lonelyloli/Portable-Multi-Parameter-Patient-Monitor-Based-ON-ESP-NOW/Schematic/PastMontFIX.sch

## EAGLE design Schematic/PastMontFIX.sch (2026-08-03)

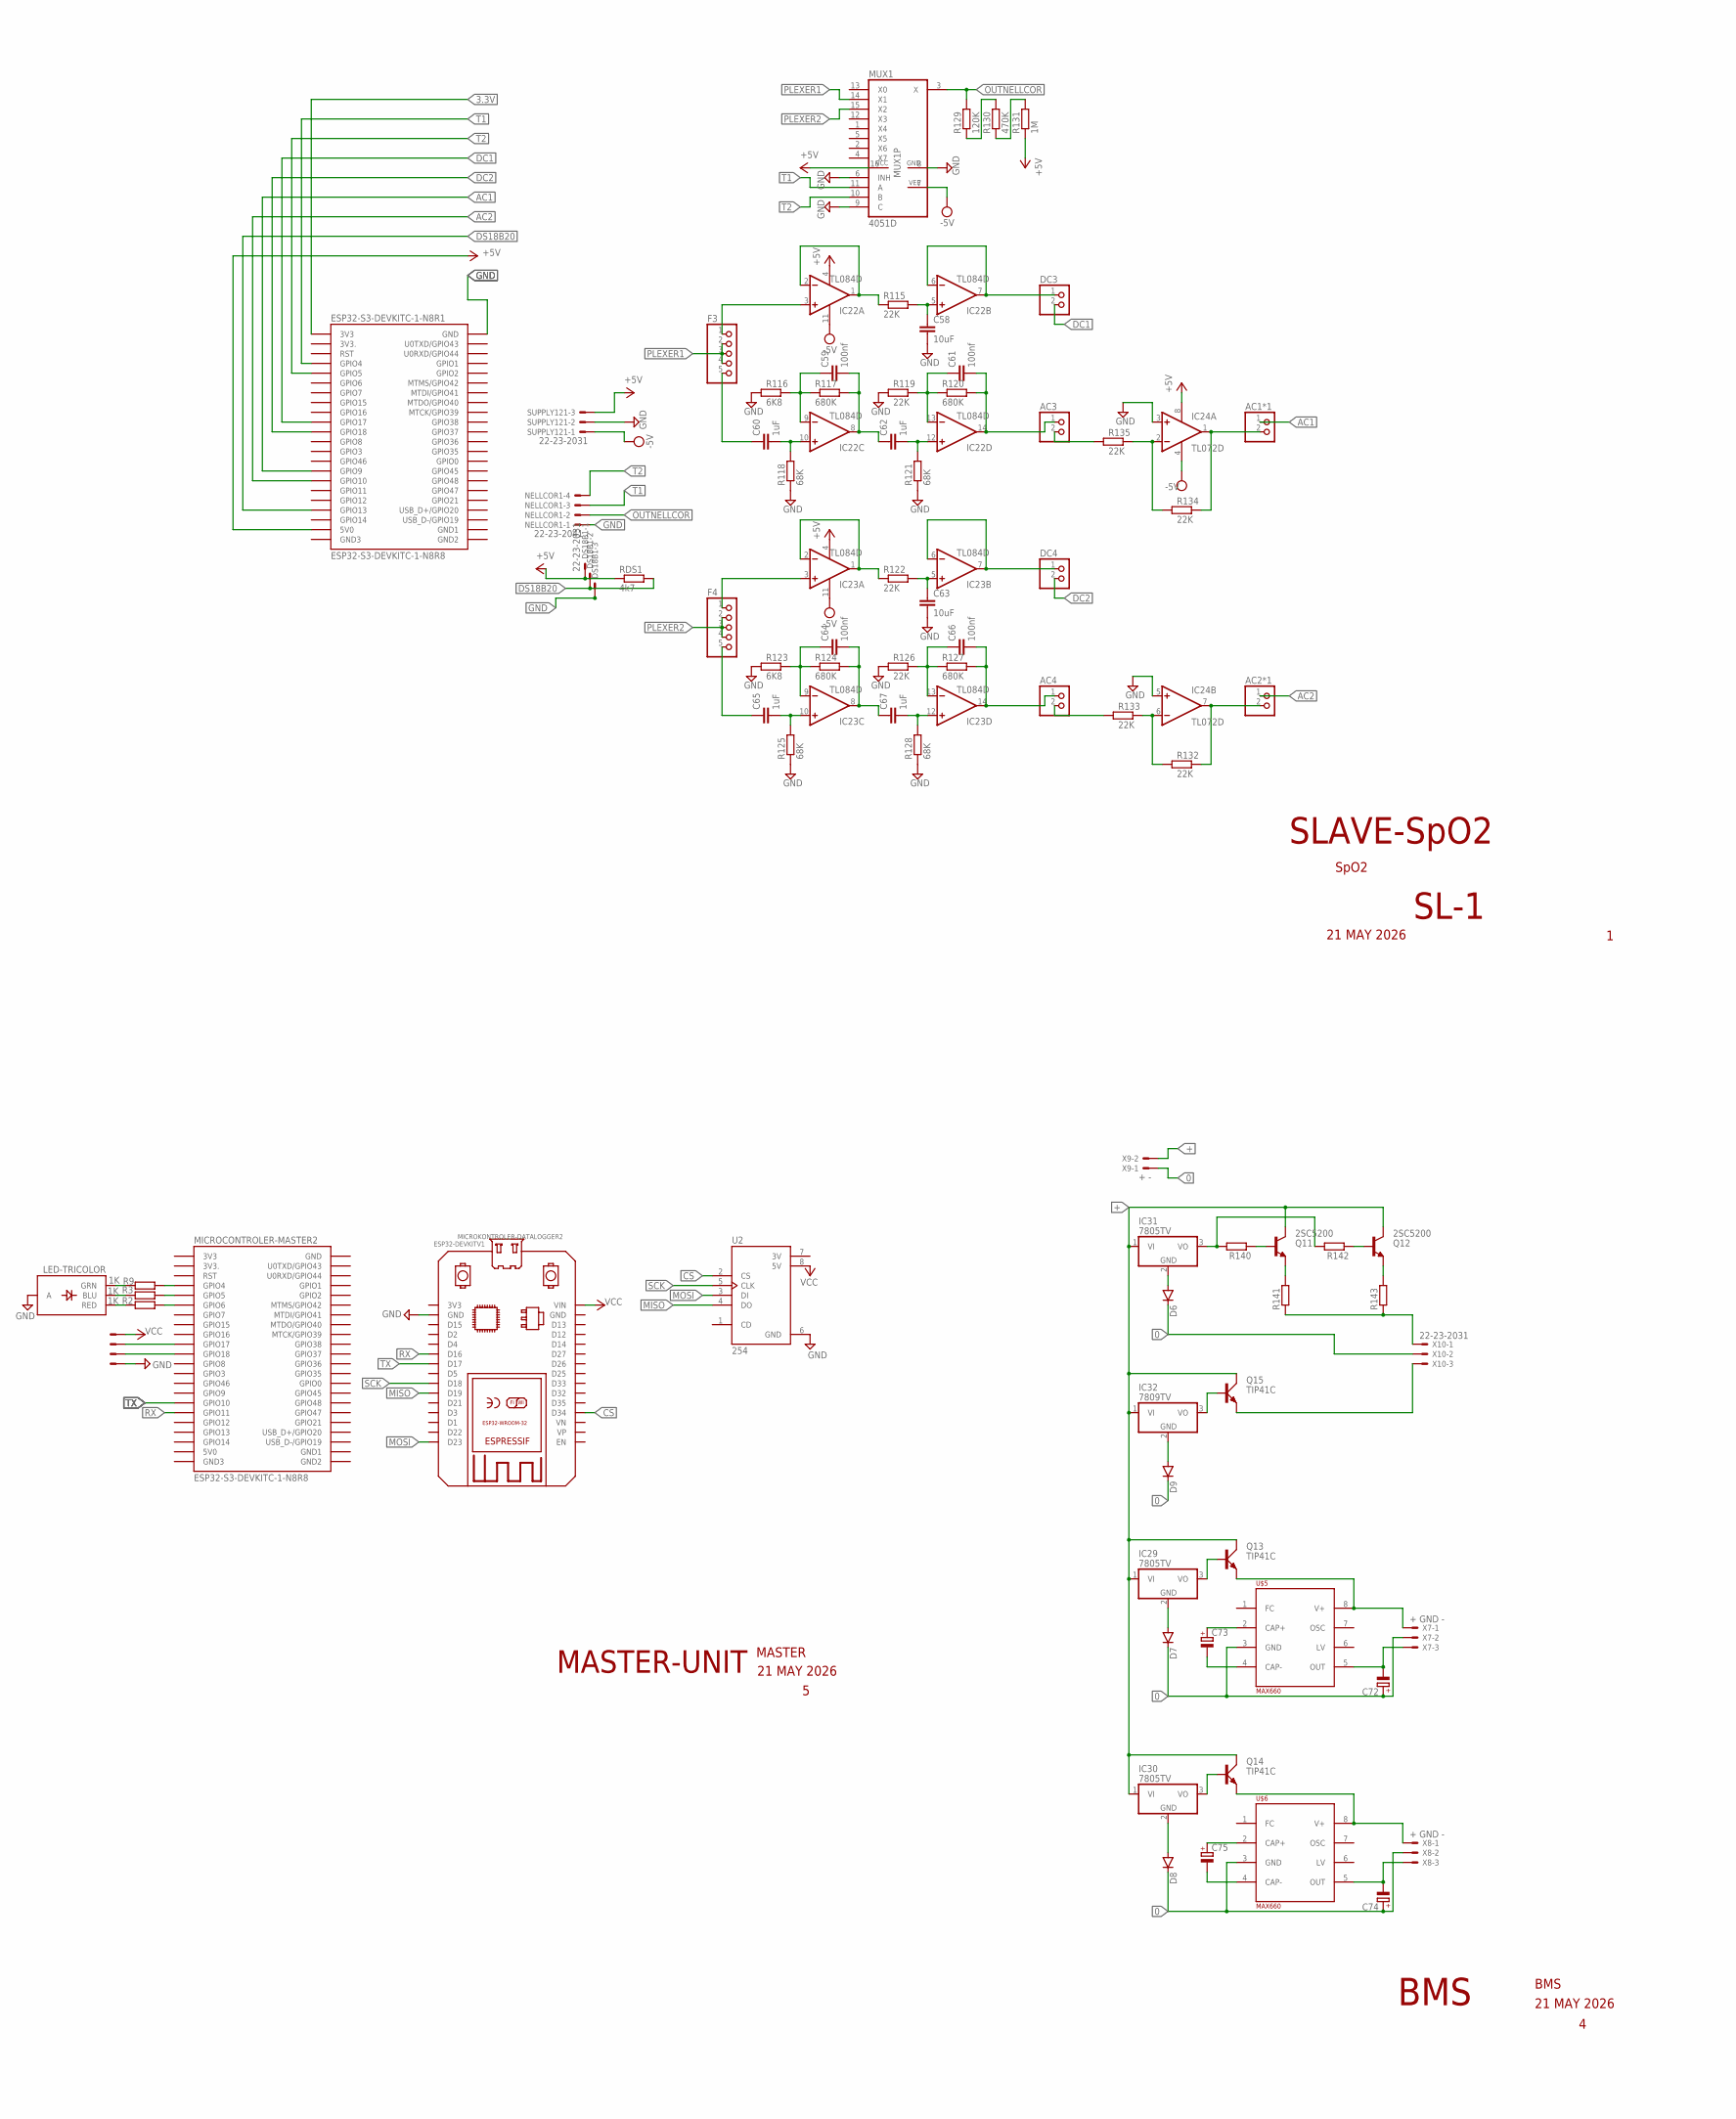
[picture p6: schematic PastMontFIX.sch, part in row 1, column 1]

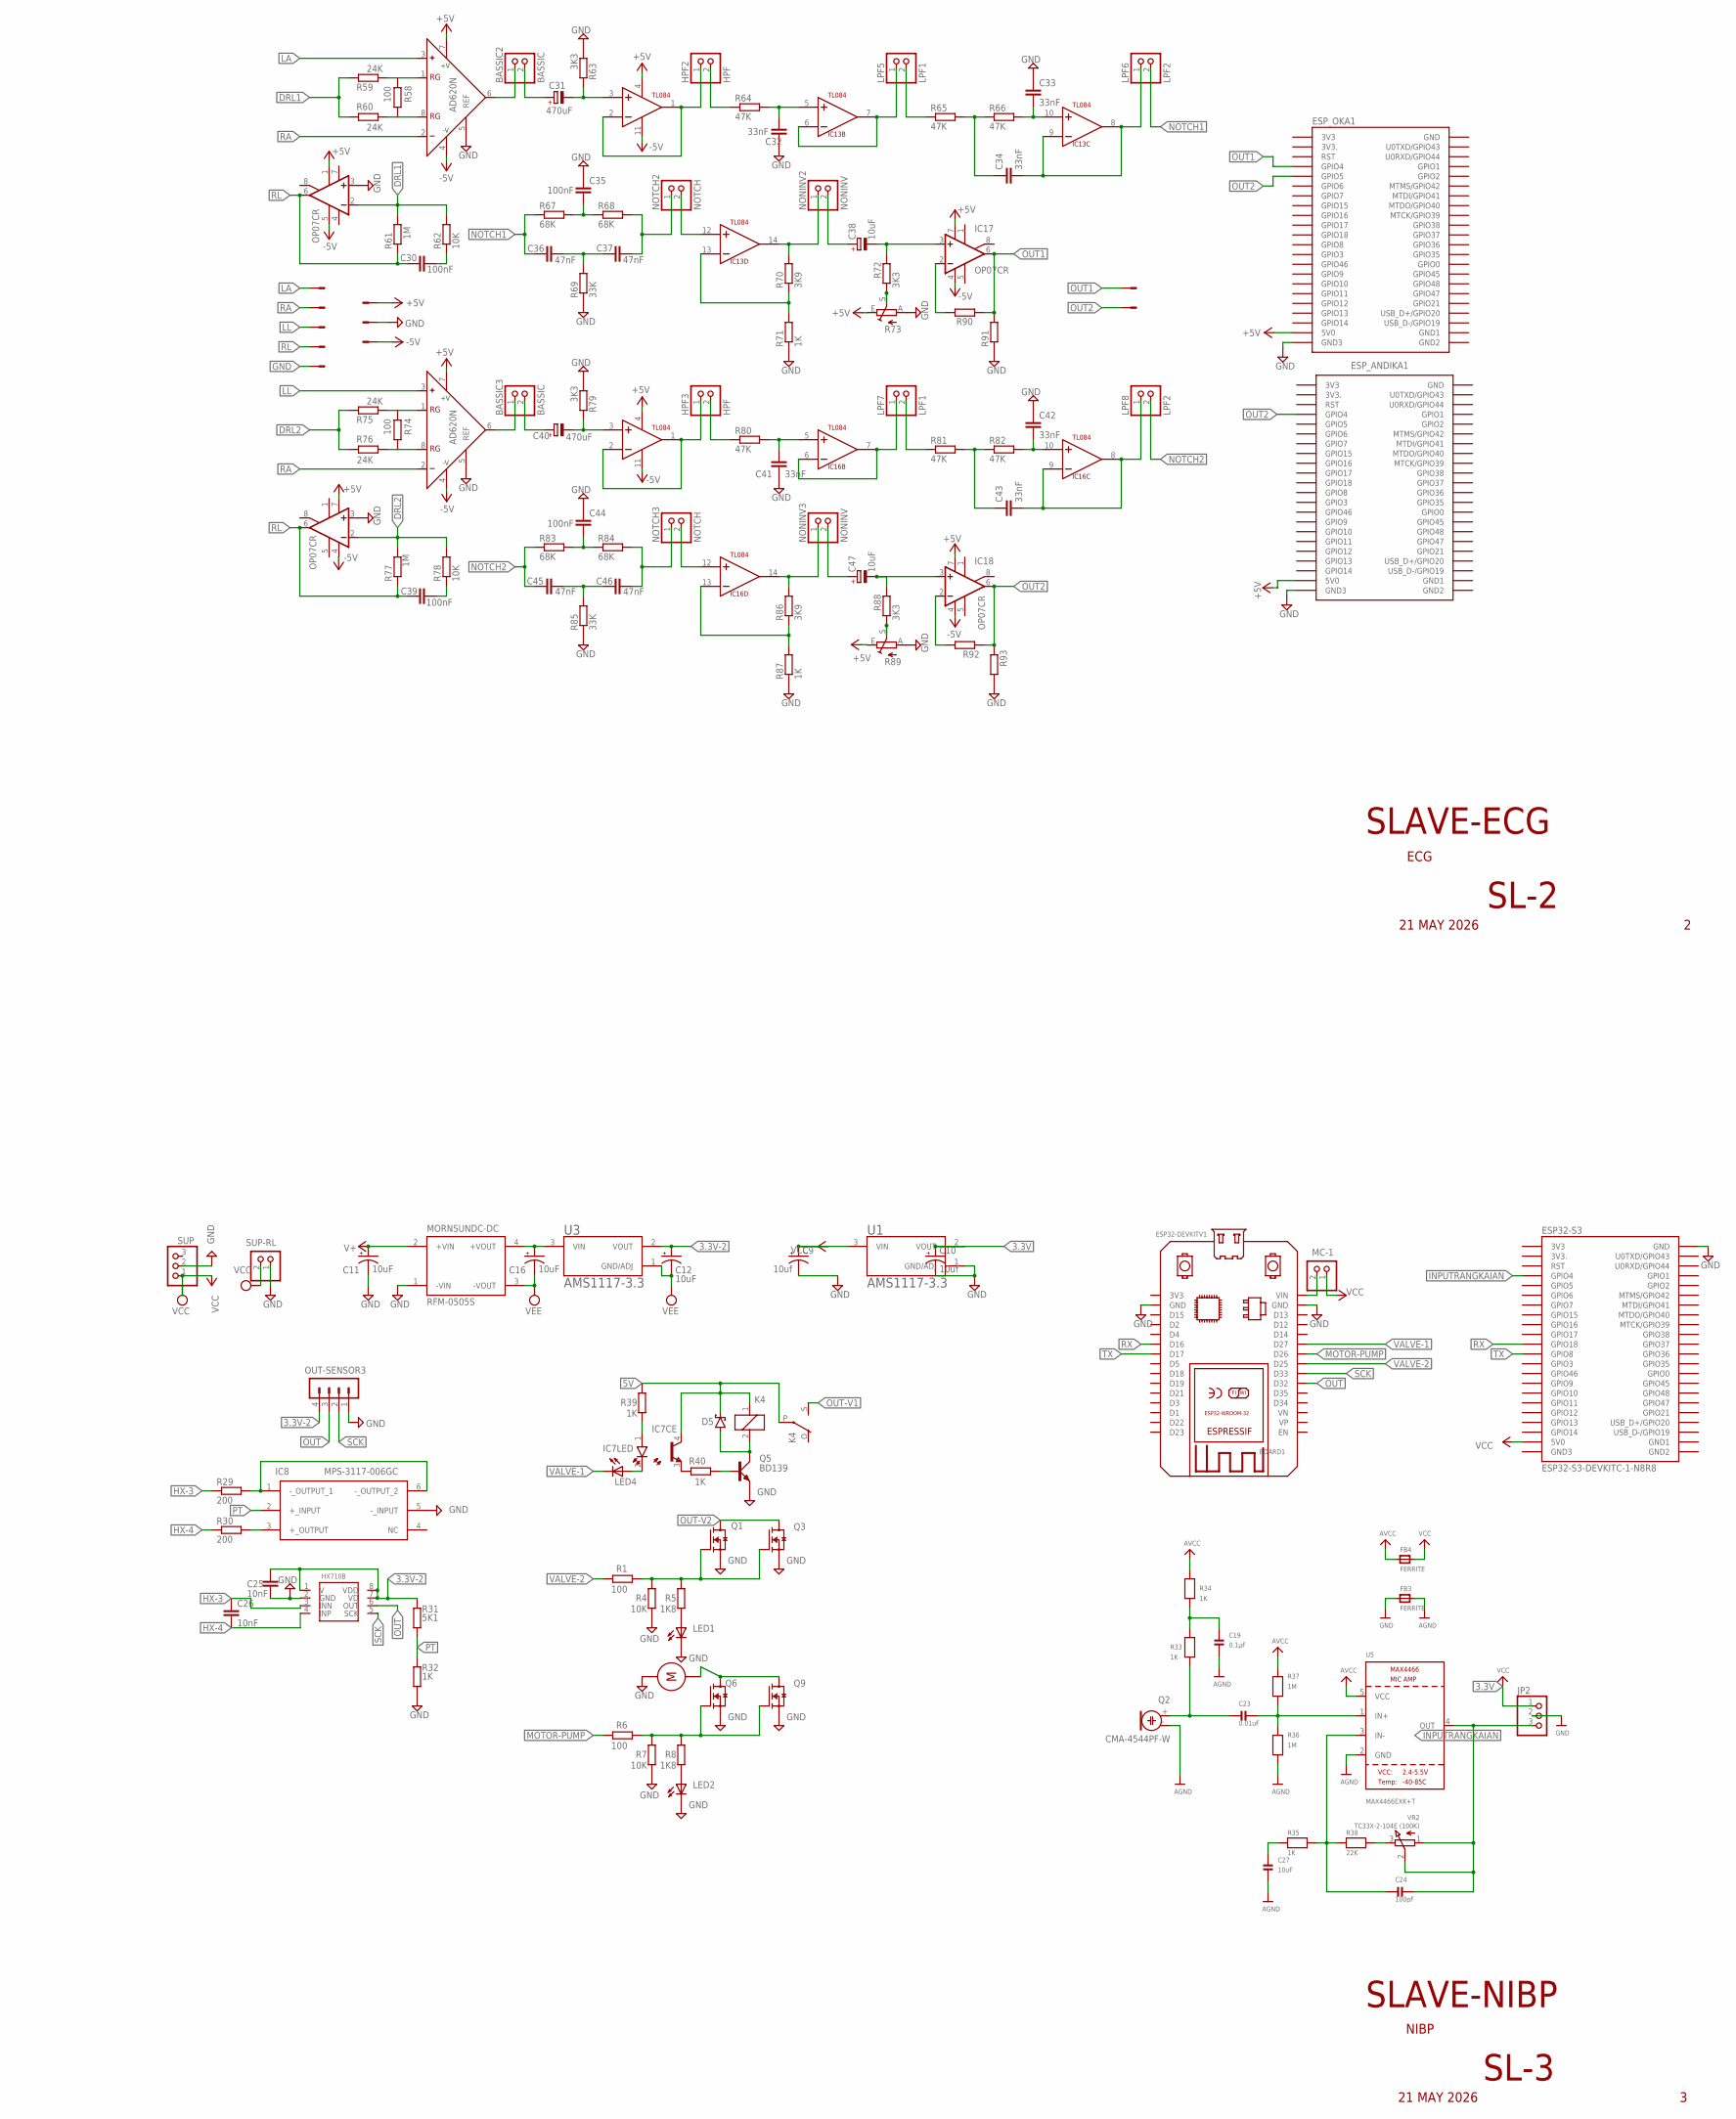
[picture p7: schematic PastMontFIX.sch, part in row 1, column 2]

Parts:
AC1*1, AC2*1, AC3, AC4: PINHD-1X2; 1X02
BASSIC2, BASSIC3: BASSIC; 1X02
BOARD1: ESP32DEVKITV1; ESP32-DEVKITV1
C9, C10: 10uf; 150CLZ-0810
C11, C12, C16: 10uF; 150CLZ-1014
C19: 0.1µF; 0805
C23: 0.01uF; 0805
C24: 100pF; 0805
C25, C26: 10nF; C1206
C27: 10uF; 0805
C30, C35, C39, C44: 100nF; C1206
C31, C40: 470uF; 150CLZ-1010
C32, C33, C34, C41, C42, C43: 33nF; C1206
C36, C37, C45, C46: 47nF; C1206
C38, C47: 10uF; 150CLZ-0810
C58, C63: 10uF; C1206
C59, C61, C64, C66: 100nf; C1206
C60, C62, C65, C67: 1uF; C1206
C72, C73, C74, C75: CPOL-EU150CLZ-0810; 150CLZ-0810
D5: MBRS130LT3; SMB
D6, D7, D8, D9: DIODE-DO41-7.6; DO41-7.6
DC3, DC4: PINHD-1X2; 1X02
DS18B1: 22-23-2031
ESP32-S3, ESP32-S3-DEVKITC-1-N8R1: ESP32-S3-DEVKITC-1-N8R8
ESP_ANDIKA1: ESP32-S3-DEVKITC-1-N8R8
ESP_OKA1: EWE; ESP32-S3-DEVKITC-1-N8R8
F3, F4: PINHD-1X5; 1X05
FB3, FB4: FERRITE; 0805
HPF2, HPF3: HPF; 1X02
HX710B: HX710B; SOP-8
IC7: SFH6156; SFH
IC8: MPS-3117-006GC; MPS3117006GC
IC11, IC14: AD620N; DIL08
IC12, IC15, IC17, IC18: OP07CR; SO08
IC13, IC16: TL084; SO14
IC22, IC23: TL084D; SO14
IC24: TL072D; SO08
IC29, IC30, IC31: 7805TV; TO220V
IC32: 7809TV; TO220V
JP2: HEADER-1X376MIL; 1X03_ROUND_76
K4: ZF112
LED1, LED2, LED4: LEDCHIPLED_1206; CHIPLED_1206
LPF5, LPF7: LPF1; 1X02
LPF6, LPF8: LPF2; 1X02
M1: 308-100
MC-1: PINHD-1X2; 1X02
MICROCONTROLER-MASTER2: ESP32-S3-DEVKITC-1-N8R8
MICROKONTROLER-DATALOGGER2: ESP32DEVKITV1; ESP32-DEVKITV1
MORNSUNDC-DC: RFM-0505S; CONV_RFM-0505S
MUX1: 4051D; SO16
NELLCOR1: 22-23-2041
NEX: 22-23-2041
NONINV2, NONINV3: NONINV; 1X02
NOTCH2, NOTCH3: NOTCH; 1X02
OUT1: 22-23-2021
OUT-SENSOR3: MA04-1
POWER1: 22-23-2031
Q1, Q3, Q6, Q9: AOD4184A; DPAK228P994X240-4N
Q2: CMA-4544PF-W; ELECTRET_9.7
Q5: BD139; TO126AV
Q11, Q12: 2SC5200; TO545P2020X520X2910-3
Q13, Q14, Q15: TIP41C; TO220AV
R1, R6: 100; M1206
R2, R3, R9, R32, R39, R40: 1K; M1206
R4, R7: 10K; M1206
R5, R8: 1K8; M1206
R29, R30: 200; M1206
R31: 5K1; M1206
R33, R34, R35: 1K; 0805
R36, R37: 1M; 0805
R38: 22K; 0805
R58, R74: 100; R1206
R59, R60, R75, R76: 24K; R1206
R61, R77, R131: 1M; R1206
R62, R78: 10K; R1206
R63, R72, R79, R88: 3K3; R1206
R64, R65, R66, R80, R81, R82: 47K; R1206
R67, R68, R83, R84, R118, R121, R125, R128: 68K; R1206
R69, R85: 33K; R1206
R70, R86: 3K9; R1206
R71, R87: 1K; R1206
R73, R89: TRIM_EU-CA6V; CA6V
R90, R91, R92, R93: R-EU_R1206; R1206
R115, R119, R122, R126, R132, R133, R134, R135: 22K; R1206
R116, R123: 6K8; R1206
R117, R120, R124, R127: 680K; R1206
R129: 120K; R1206
R130: 470K; R1206
R140, R142: R-EU_0617/17; 0617/17
R141, R143: R-EU_0922/22; 0922/22
RDS1: 4k7; R1206
SUP: PINHD-1X3; 1X03
SUP-RL: PINHD-1X2; 1X02
SUPPLY121: 22-23-2031
U1, U3: AMS1117-3.3; SOT229P700X180-4N
U2: 254; MODULE_254
U5: MAX4466EXK+T; SC70-5
U$2: LED-TRICOLOR; LED-TRICOLOR-SMD
U$5, U$6: MAX660; SO08
VR2: TC33X-2-104E (100K); TRIMPOT_BOURNS_TC33X-2
X2: 22-23-2051
X7, X8: + GND -; 22-23-2031
X9: + -; 22-23-2021
X10: 22-23-2031

Connections:
0: C72.+, C74.+, D6.C, D7.C, D8.C, D9.C, U$5.3 (GND), U$6.3 (GND), X7.2, X8.2, X9.1, X10.2
3.3V: C10.+, ESP32-S3-DEVKITC-1-N8R1.J1_1 (3V3), JP2.1, U1.2 (VOUT)
3.3V-2: C12.+, C25.1, HX710B.1 (V), HX710B.7 (VD), HX710B.8 (VDD), OUT-SENSOR3.4, R31.1, U3.2 (VOUT)
5V: D5.C, IC7.4 (C), K4.1, K4.P, R39.2
+: IC29.1 (VI), IC30.1 (VI), IC31.1 (VI), IC32.1 (VI), Q11.2 (C), Q12.2 (C), Q13.C, Q14.C, Q15.C, X9.2
+5V: ESP_ANDIKA1.J1_21 (5V0), ESP_OKA1.J1_21 (5V0), IC11.4 (-V), IC11.7 (+V), IC12.1 (ON1), IC12.5 (OPT), IC13.4 (VCC+), IC13.11 (VCC-), IC14.4 (-V), IC14.7 (+V), IC15.4 (V-), IC15.7 (V+), IC16.4 (VCC+), IC16.11 (VCC-), IC17.4 (V-), IC17.7 (V+), IC18.4 (V-), IC18.7 (V+), POWER1.1, POWER1.3, R73.E, R89.E
AC1: AC1*1.1, ESP32-S3-DEVKITC-1-N8R1.J1_15 (GPIO9)
AC2: AC2*1.1, ESP32-S3-DEVKITC-1-N8R1.J1_16 (GPIO10)
AGND: C19.2, C27.2, FB3.2, Q2.- (1), R36.1, U5.2 (GND)
AVCC: FB4.1, R34.2, R37.2, U5.5 (VCC)
CS: MICROKONTROLER-DATALOGGER2.D34, U2.2 (CS)
DC1: DC3.2, ESP32-S3-DEVKITC-1-N8R1.J1_10 (GPIO17)
DC2: DC4.2, ESP32-S3-DEVKITC-1-N8R1.J1_11 (GPIO18)
DRL1: IC12.2 (-IN), R59.2, R60.2, R61.2, R62.2
DRL2: IC15.2 (-IN), R75.2, R76.2, R77.2, R78.2
DS18B20: DS18B1.2, ESP32-S3-DEVKITC-1-N8R1.J1_19 (GPIO13), RDS1.2
GND: BOARD1.GND, BOARD1.GND@1 (GND), C9.-, C10.-, C11.-, C25.2, C32.2, C33.1, C35.1, C41.2, C42.1, C44.1, C58.2, C63.2, DS18B1.3, ESP32-S3.J3_1 (GND), ESP32-S3-DEVKITC-1-N8R1.J3_1 (GND), ESP_ANDIKA1.J1_22 (GND3), ESP_OKA1.J1_22 (GND3), FB3.1, HX710B.2 (GND), IC8.5 (-_INPUT), IC11.5 (REF), IC12.3 (+IN), IC14.5 (REF), IC15.3 (+IN), IC24.3 (+IN), IC24.5 (+IN), JP2.2, LED1.C, LED2.C, M1.NEG, MICROKONTROLER-DATALOGGER2.GND@1 (GND), MORNSUNDC-DC.1 (-VIN), MUX1.6 (INH), MUX1.8 (GND), MUX1.9 (C), NELLCOR1.1, NEX.4, OUT-SENSOR3.1, POWER1.2, Q1.3 (S), Q3.3 (S), Q5.E, Q6.3 (S), Q9.3 (S), R4.1, R7.1, R32.2, R63.1, R69.1, R71.1, R73.A, R79.1, R85.1, R87.1, R89.A, R91.1, R93.2, R116.1, R118.1, R119.1, R121.1, R123.1, R125.1, R126.1, R128.1, SUP.2, SUP-RL.1, SUPPLY121.2, U1.1 (GND/ADJ), U2.6 (GND), U$2.A, X2.5
HX-3: C26.1, HX710B.3 (INN), R29.1
HX-4: C26.2, HX710B.4 (INP), R30.1
INPUTRANGKAIAN: C24.1, ESP32-S3.J1_4 (GPIO4), JP2.3, U5.4 (OUT), VR2.1 (A), VR2.2 (S)
LA: IC11.3 (+), X2.1
LL: IC14.3 (+), X2.3
MISO: MICROKONTROLER-DATALOGGER2.D19, U2.4 (DO)
MOSI: MICROKONTROLER-DATALOGGER2.D23, U2.3 (DI)
MOTOR-PUMP: BOARD1.D26, R6.1
unnamed: LED1.A, R5.1
unnamed: C16.+, MORNSUNDC-DC.4 (+VOUT), U3.3 (VIN)
unnamed: Q1.1 (G), Q3.1 (G), R1.2, R4.2, R5.2
unnamed: LED2.A, R8.1
unnamed: Q6.1 (G), Q9.1 (G), R6.2, R7.2, R8.2
unnamed: R9.1, U$2.G (GRN)
unnamed: R3.1, U$2.B (BLU)
unnamed: R2.1, U$2.R (RED)
unnamed: MICROCONTROLER-MASTER2.J1_6 (GPIO6), R2.2
unnamed: MICROCONTROLER-MASTER2.J1_5 (GPIO5), R3.2
unnamed: BOARD1.VIN, MC-1.2
unnamed: MICROCONTROLER-MASTER2.J1_4 (GPIO4), R9.2
unnamed: MICROCONTROLER-MASTER2.J1_10 (GPIO17), NEX.2
unnamed: MICROCONTROLER-MASTER2.J1_11 (GPIO18), NEX.3
unnamed: IC8.1 (-_OUTPUT_1), IC8.6 (-_OUTPUT_2), R29.2
unnamed: IC8.3 (+_OUTPUT), R30.2
unnamed: C23.1, Q2.+ (2), R33.1
unnamed: C19.1, R33.2, R34.1
unnamed: C23.2, R36.2, R37.1, U5.1 (IN+)
unnamed: C24.2, R35.2, R38.1, U5.3 (IN-)
unnamed: C27.1, R35.1
unnamed: R38.2, VR2.3 (E)
unnamed: Q5.B, R40.1
unnamed: D5.A, K4.2, Q5.C
unnamed: IC7.2 (K), LED4.A
unnamed: IC7.1 (A), R39.1
unnamed: IC7.3 (E), R40.2
unnamed: IC11.8 (RG), R58.1, R60.1
unnamed: IC11.1 (RG), R58.2, R59.1
unnamed: BASSIC2.1, IC11.6 (OUT)
unnamed: BASSIC2.2, C31.+
unnamed: C31.-, IC13.3 (IN+), R63.2
unnamed: HPF2.1, IC13.1 (OUT), IC13.2 (IN-)
unnamed: C32.1, IC13.5 (IN+), R64.2
unnamed: IC13.6 (IN-), IC13.7 (OUT), LPF5.1
unnamed: C34.1, R65.2, R66.1
unnamed: C33.2, IC13.10 (IN+), R66.2
unnamed: C34.2, IC13.8 (OUT), IC13.9 (IN-), LPF6.1
unnamed: C35.2, R67.2, R68.1
unnamed: C36.2, C37.1, R69.2
unnamed: C37.2, NOTCH2.1, R68.2
unnamed: HPF2.2, R64.1
unnamed: LPF5.2, R65.1
unnamed: IC13.14 (OUT), NONINV2.1, R70.2
unnamed: IC13.13 (IN-), R70.1, R71.2
unnamed: C38.+, NONINV2.2
unnamed: R72.1, R73.S
unnamed: IC13.12 (IN+), NOTCH2.2
unnamed: C30.2, R62.1
unnamed: IC14.8 (RG), R74.1, R76.1
unnamed: IC14.1 (RG), R74.2, R75.1
unnamed: BASSIC3.1, IC14.6 (OUT)
unnamed: BASSIC3.2, C40.+
unnamed: C40.-, IC16.3 (IN+), R79.2
unnamed: HPF3.1, IC16.1 (OUT), IC16.2 (IN-)
unnamed: C41.1, IC16.5 (IN+), R80.2
unnamed: IC16.6 (IN-), IC16.7 (OUT), LPF7.1
unnamed: C43.1, R81.2, R82.1
unnamed: C42.2, IC16.10 (IN+), R82.2
unnamed: C43.2, IC16.8 (OUT), IC16.9 (IN-), LPF8.1
unnamed: C44.2, R83.2, R84.1
unnamed: C45.2, C46.1, R85.2
unnamed: C46.2, NOTCH3.1, R84.2
unnamed: HPF3.2, R80.1
unnamed: LPF7.2, R81.1
unnamed: IC16.14 (OUT), NONINV3.1, R86.2
unnamed: IC16.13 (IN-), R86.1, R87.2
unnamed: C47.+, NONINV3.2
unnamed: R88.1, R89.S
unnamed: IC16.12 (IN+), NOTCH3.2
unnamed: C39.2, R78.1
unnamed: IC17.2 (-IN), R90.1
unnamed: IC18.2 (-IN), R92.2
unnamed: C47.-, IC18.3 (+IN), R88.2
unnamed: C38.-, IC17.3 (+IN), R72.2
unnamed: IC22.1 (OUT), IC22.2 (-IN), R115.1
unnamed: DC3.1, IC22.6 (-IN), IC22.7 (OUT)
unnamed: C58.1, IC22.5 (+IN), R115.2
unnamed: C59.2, C62.1, IC22.8 (OUT), R117.2
unnamed: C59.1, IC22.9 (-IN), R116.2, R117.1
unnamed: C60.2, IC22.10 (+IN), R118.2
unnamed: C62.2, IC22.12 (+IN), R121.2
unnamed: C61.1, IC22.13 (-IN), R119.2, R120.1
unnamed: AC3.1, C61.2, IC22.14 (OUT), R120.2
unnamed: F3.1, IC22.3 (+IN)
unnamed: C60.1, F3.5
unnamed: IC23.1 (OUT), IC23.2 (-IN), R122.1
unnamed: DC4.1, IC23.6 (-IN), IC23.7 (OUT)
unnamed: C63.1, IC23.5 (+IN), R122.2
unnamed: C64.2, C67.1, IC23.8 (OUT), R124.2
unnamed: C64.1, IC23.9 (-IN), R123.2, R124.1
unnamed: C65.2, IC23.10 (+IN), R125.2
unnamed: C67.2, IC23.12 (+IN), R128.2
unnamed: C66.1, IC23.13 (-IN), R126.2, R127.1
unnamed: AC4.1, C66.2, IC23.14 (OUT), R127.2
unnamed: F4.1, IC23.3 (+IN)
unnamed: C65.1, F4.5
unnamed: R129.1, R130.2
unnamed: R130.1, R131.2
unnamed: IC24.2 (-IN), R134.1, R135.2
unnamed: AC1*1.2, IC24.1 (OUT), R134.2
unnamed: AC2*1.2, IC24.7 (OUT), R132.2
unnamed: IC24.6 (-IN), R132.1, R133.2
unnamed: AC3.2, R135.1
unnamed: AC4.2, R133.1
unnamed: C73.+, U$5.2 (CAP+)
unnamed: C73.-, U$5.4 (CAP-)
unnamed: C72.-, U$5.5 (OUT), X7.3
unnamed: Q13.E, U$5.8 (V+), X7.1
unnamed: C75.+, U$6.2 (CAP+)
unnamed: C75.-, U$6.4 (CAP-)
unnamed: C74.-, U$6.5 (OUT), X8.3
unnamed: Q14.E, U$6.8 (V+), X8.1
unnamed: IC31.3 (VO), R140.2, R142.2
unnamed: Q11.1 (B), R140.1
unnamed: Q11.3 (E), R141.2
unnamed: Q12.1 (B), R142.1
unnamed: Q12.3 (E), R143.2
unnamed: R141.1, R143.1, X10.1
unnamed: D6.A, IC31.2 (GND)
unnamed: IC29.3 (VO), Q13.B
unnamed: IC30.3 (VO), Q14.B
unnamed: IC32.3 (VO), Q15.B
unnamed: D8.A, IC30.2 (GND)
unnamed: D7.A, IC29.2 (GND)
unnamed: D9.A, IC32.2 (GND)
unnamed: Q15.E, X10.3
NOTCH1: C36.1, LPF6.2, R67.1
NOTCH2: C45.1, LPF8.2, R83.1
OUT: BOARD1.D32, HX710B.6 (OUT), OUT-SENSOR3.3
OUT1: ESP_OKA1.J1_4 (GPIO4), IC17.6 (OUT), OUT1.1, R90.2, R91.2
OUT2: ESP_ANDIKA1.J1_4 (GPIO4), ESP_OKA1.J1_5 (GPIO5), IC18.6 (OUT), OUT1.2, R92.1, R93.1
OUT-MP: M1.POS, Q6.4 (D), Q9.4 (D)
OUT-V1: K4.S
OUT-V2: Q1.4 (D), Q3.4 (D)
OUTNELLCOR: MUX1.3 (X), NELLCOR1.2, R129.2
PLEXER1: F3.2, F3.3, F3.4, MUX1.14 (X1)
PLEXER2: F4.2, F4.3, F4.4, MUX1.15 (X2)
PT: IC8.2 (+_INPUT), R31.2, R32.1
RA: IC11.2 (-), IC14.2 (-), X2.2
RL: C30.1, C39.1, IC12.6 (OUT), IC15.6 (OUT), R61.1, R77.1, X2.4
RX: BOARD1.D16, ESP32-S3.J1_11 (GPIO18), MICROCONTROLER-MASTER2.J1_17 (GPIO11), MICROKONTROLER-DATALOGGER2.D16
SCK: BOARD1.D33, HX710B.5 (SCK), MICROKONTROLER-DATALOGGER2.D18, OUT-SENSOR3.2, U2.5 (CLK)
T1: ESP32-S3-DEVKITC-1-N8R1.J1_4 (GPIO4), MUX1.11 (A), NELLCOR1.3
T2: ESP32-S3-DEVKITC-1-N8R1.J1_5 (GPIO5), MUX1.10 (B), NELLCOR1.4
TX: BOARD1.D17, ESP32-S3.J1_12 (GPIO8), MICROCONTROLER-MASTER2.J1_16 (GPIO10), MICROKONTROLER-DATALOGGER2.D17
V+: C11.+, MORNSUNDC-DC.2 (+VIN)
VALVE-1: BOARD1.D27, LED4.C
VALVE-2: BOARD1.D25, R1.1
VCC: C9.+, DS18B1.1, ESP32-S3.J1_21 (5V0), ESP32-S3-DEVKITC-1-N8R1.J1_21 (5V0), FB4.2, IC22.4 (V+), IC23.4 (V+), IC24.8 (V+), MC-1.1, MICROKONTROLER-DATALOGGER2.VIN, MUX1.16 (VCC), NEX.1, R131.1, RDS1.1, SUP.1, SUP-RL.2, SUPPLY121.3, U1.3 (VIN), U2.8 (5V)
VEE: C12.-, C16.-, IC22.11 (V-), IC23.11 (V-), IC24.4 (V-), MORNSUNDC-DC.3 (-VOUT), MUX1.7 (VEE), SUPPLY121.1, U3.1 (GND/ADJ)

Notes on the sheet:
NIBP
SLAVE-NIBP
MASTER
SLAVE-ECG
SLAVE-SpO2
ECG
BMS
21 MAY 2026
SpO2
MASTER-UNIT
SL-1
SL-2
SL-3
