lonelyloli/Portable-Multi-Parameter-Patient-Monitor-Based-ON-ESP-NOW/(commit log)

2026-08-03 Revise README to enhance project description
    The updated description provides a detailed overview of the portable, multi-parameter patient monitor system, highlighting its components, functionality, and validation results.
2026-08-03 Create Schematic
2026-08-03 Schematic
    Schematic
    [PastMontFIX.sch]
2026-08-03 Create Non Invansive Blood Pressure
2026-08-03 Revise README for improved clarity and structure
    Updated the README to improve clarity and structure, including a detailed overview of the portable multi-parameter patient monitor, its features, system architecture, and validation results.
